nnm-t/stm32g051f8p6-visitor-counter/Core/Inc/main.h

#define CH340N_RX_Pin GPIO_PIN_7
#define CH340N_RX_GPIO_Port GPIOB
#define SW1_Pin GPIO_PIN_0
#define SW1_GPIO_Port GPIOA
#define SW1_EXTI_IRQn EXTI0_1_IRQn
#define SW2_Pin GPIO_PIN_1
#define SW2_GPIO_Port GPIOA
#define SW2_EXTI_IRQn EXTI0_1_IRQn
#define LED1_Pin GPIO_PIN_2
#define LED1_GPIO_Port GPIOA
#define LED2_Pin GPIO_PIN_3
#define LED2_GPIO_Port GPIOA
#define SD_CS_Pin GPIO_PIN_4
#define SD_CS_GPIO_Port GPIOA
#define SD_SCK_Pin GPIO_PIN_5
#define SD_SCK_GPIO_Port GPIOA
#define SD_MISO_Pin GPIO_PIN_6
#define SD_MISO_GPIO_Port GPIOA
#define SD_MOSI_Pin GPIO_PIN_7
#define SD_MOSI_GPIO_Port GPIOA
#define BZ1_Pin GPIO_PIN_1
#define BZ1_GPIO_Port GPIOB
#define PCF8563_SCL_Pin GPIO_PIN_11
#define PCF8563_SCL_GPIO_Port GPIOA
#define PCF8563_SDA_Pin GPIO_PIN_12
#define PCF8563_SDA_GPIO_Port GPIOA
#define CH340N_TX_Pin GPIO_PIN_6
#define CH340N_TX_GPIO_Port GPIOB
