nnm-t/stm32g051f8p6-visitor-counter/(commit log)

2026-02-14 fix UART & I2C
    [app_main.cpp, pcf8563.cpp, pcf8563.h, visitor_counter.cpp]
2026-02-18 Now fixing TF I/O...
    [stm32g051f8p6-visitor-counter.ioc, visitor_counter.cpp]
2026-02-26 fix TF initialize operation
    [stm32g051f8p6-visitor-counter.ioc]
2026-03-22 Now fixing TF CMD17 operation...
    [stm32g051f8p6-visitor-counter.ioc]
